ahmetdemirdas/EE493-Revolusys/Documents/About Programming/Image Acquisition Subsytem/test.jpg

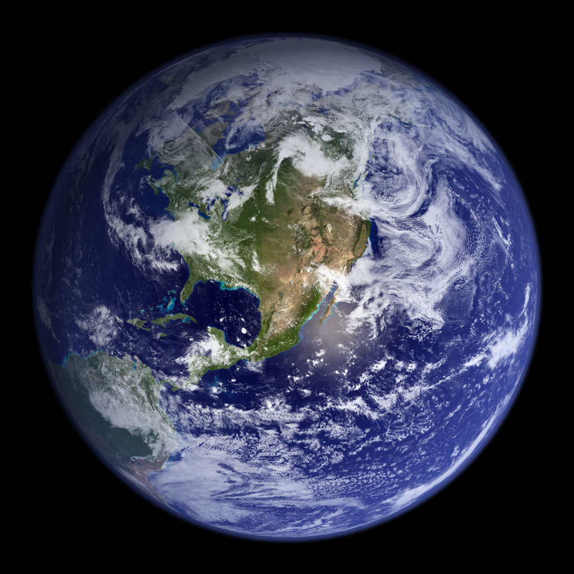
Documents/About Programming/Image Acquisition Subsytem/test.jpg
