ahmetdemirdas/EE493-Revolusys/Documents/About Simulation/layout.jpg

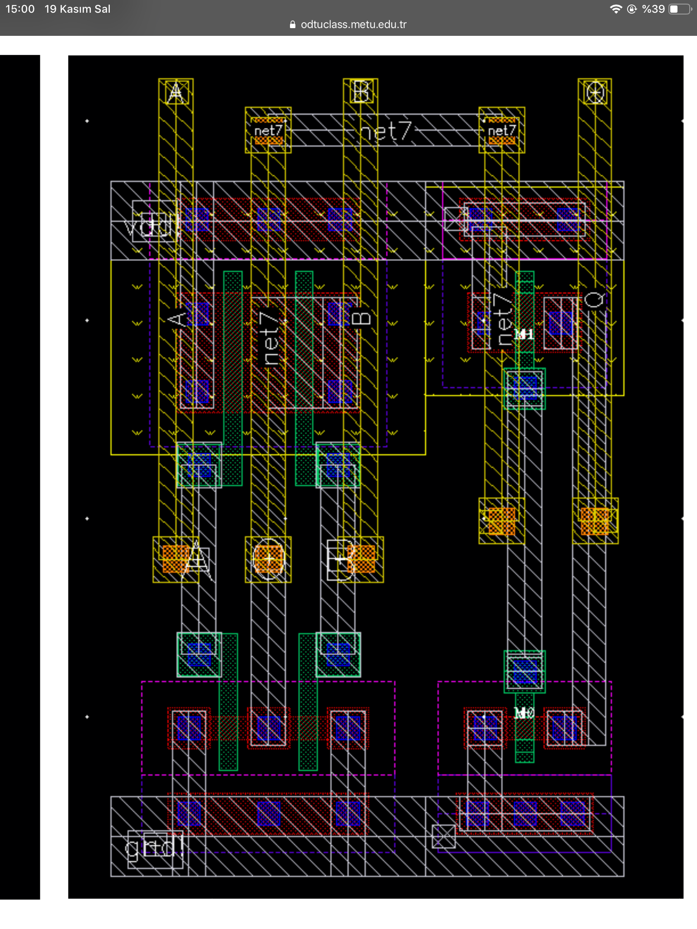
Documents/About Simulation/layout.jpg
