ahmetdemirdas/EE493-Revolusys/README.md

# EE493-Revolusys
This repository serves to EE493/Revolusys Group
