ahmetdemirdas/EE493-Revolusys/Reports/ee493-revolusys-module_demo-corrected.pdf

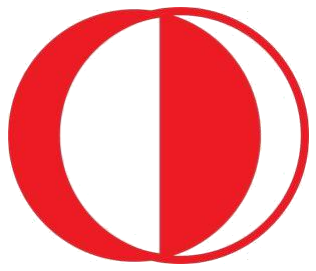
[picture p88: figure]

## MIDDLE EAST TECHNICAL UNIVERSITY

_______________________________________________________

### DEPARTMENT OF ELECTRICAL AND ELECTRONICS

### ENGINEERING

_______________________________________________________

EE 493-DESIGN STUDIO 1

MODULE DEMO

14.12.2019

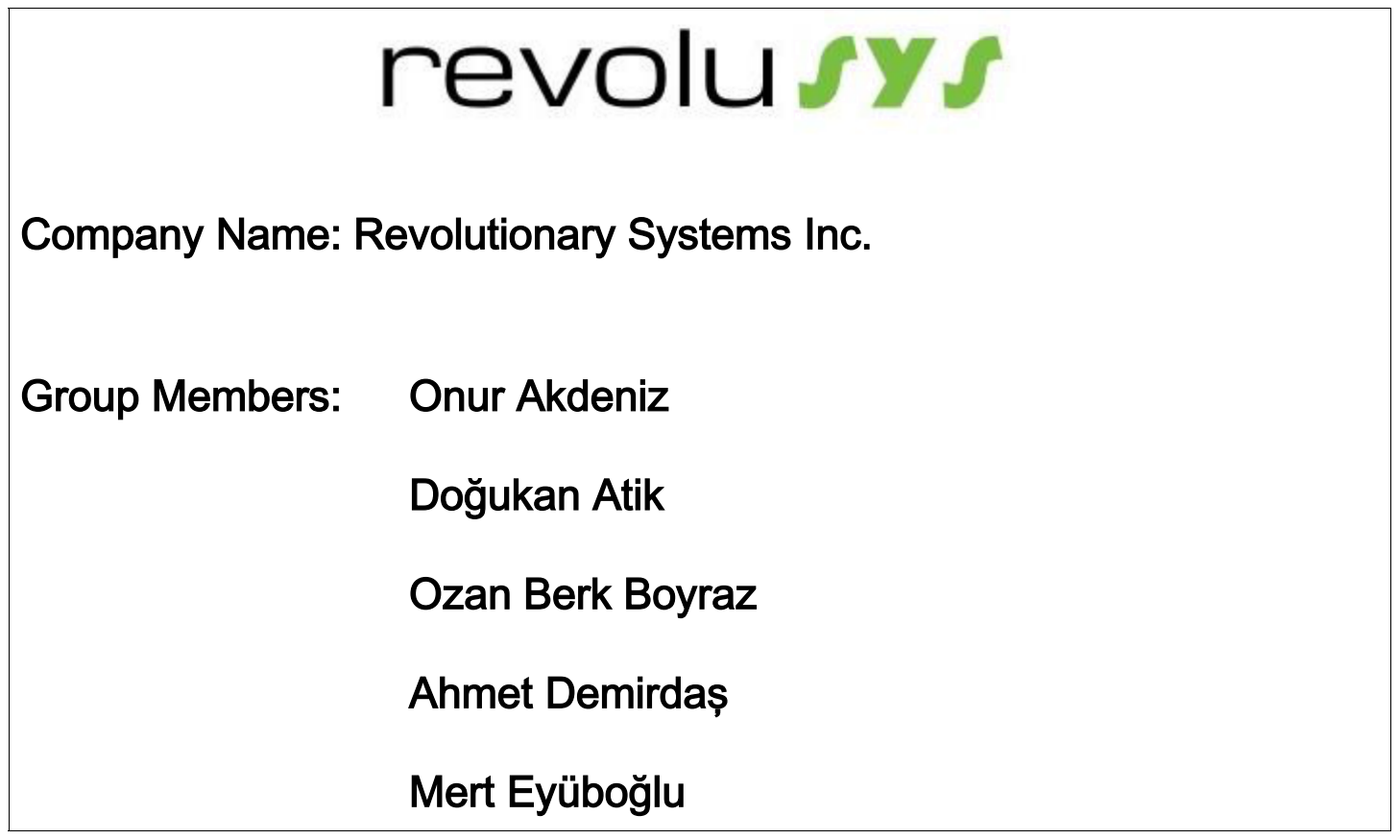
[picture p89: figure]
Group Members:; Onur Akdeniz; Doğukan Atik; Ozan Berk Boyraz; Ahmet Demirdaş; Mert Eyüboğlu

Company Name: Revolutionary Systems Inc.

### 1. Introduction

In Module Demo, Revolusys demonstrated the communication system that utilizes the on-off modulation at 10 kBit/sec data speed. The prepared test plan is described in the following section.

### 2. The Test Plan

The test data stream was upload to input as input and output of the system for transmitter led to receiver photodiode distances from 5 cm to 10 cm (with 1 cm steps) and for different light conditions (dark, lab light , intense light) was observed. This process was repeated 50 times for lab light while it was not performed more than 5 times for other light conditions.

In this demonstration, to illustrate the proper operation of the commination system, 150 bit message signal was transmitted. The number of message bit was selected arbitrarily, the communication system will transmit more than 150 bit at once on its operation. The transmitted stream starts with 6 bit preamble array, “1-1-1-1-1-0”. After this 6 bit of array, “1” bit is sent. After receiving last bit of preamble, “0”, receiver searches for a rising edge. With the rising edge, transmitter arranges its sampling point to mid-point of the high or low durations, to decrease the error. After this 7 bit of information, 150 bit message signal is sent. After 150 bit of message signal, transmitter stops transmitting.

The received data (with digital read command of Arduino), was read on the COM screen of Arduino and compared with the message signal in MATLAB. The number of error in the received 150 bit message signal was determined for different trials and the result seen in Figure 1 was obtained.

The test setups for different conditions are seen from Figure 1 to Figure 3.

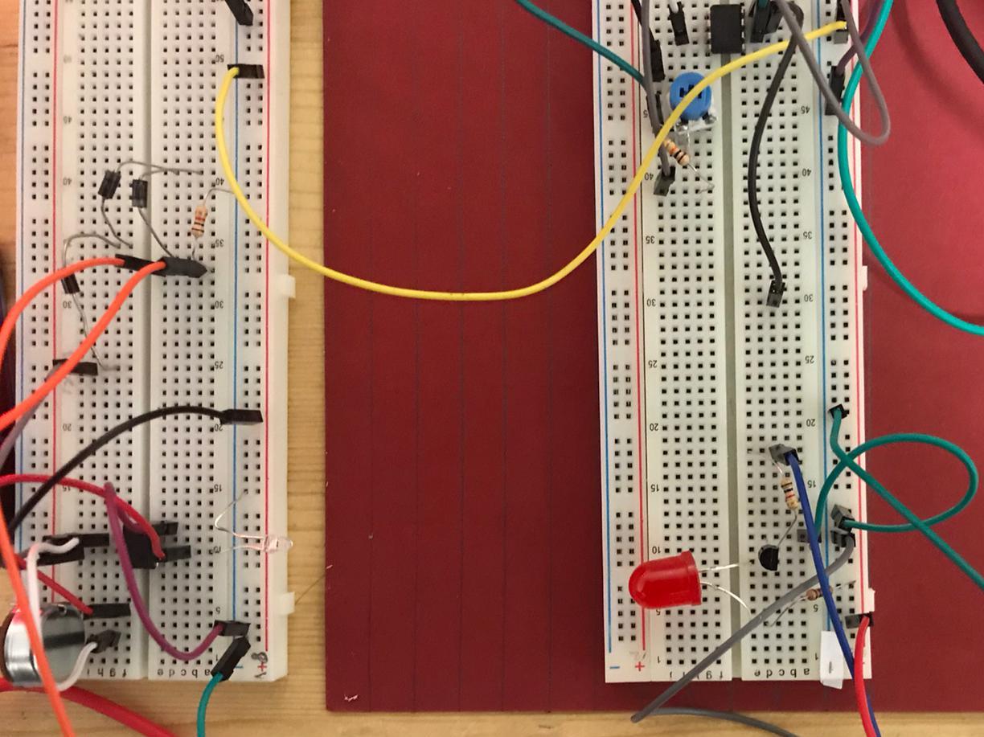
[picture p90: figure]

Figure 1: The setup for lab light condition tests.

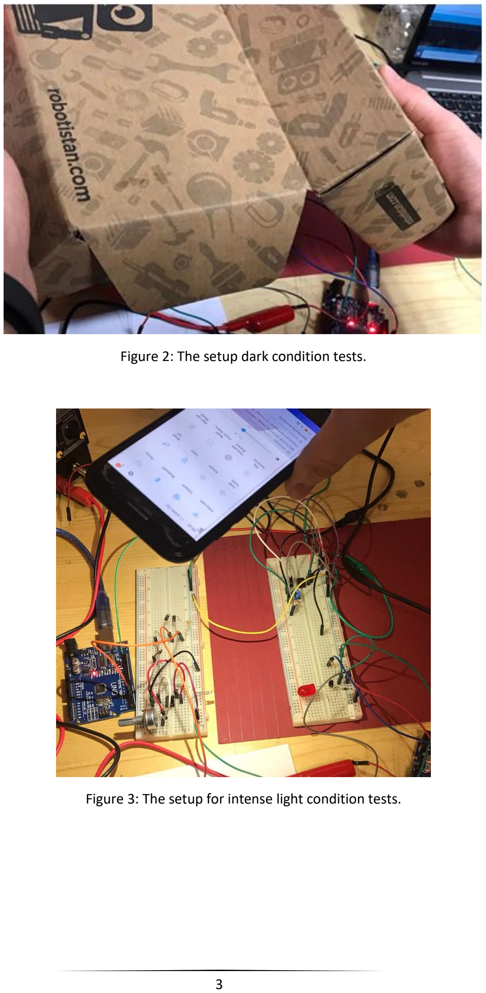
[picture p91: page 3]

Figure 2: The setup dark condition tests.

Figure 3: The setup for intense light condition tests.

### 3. Results

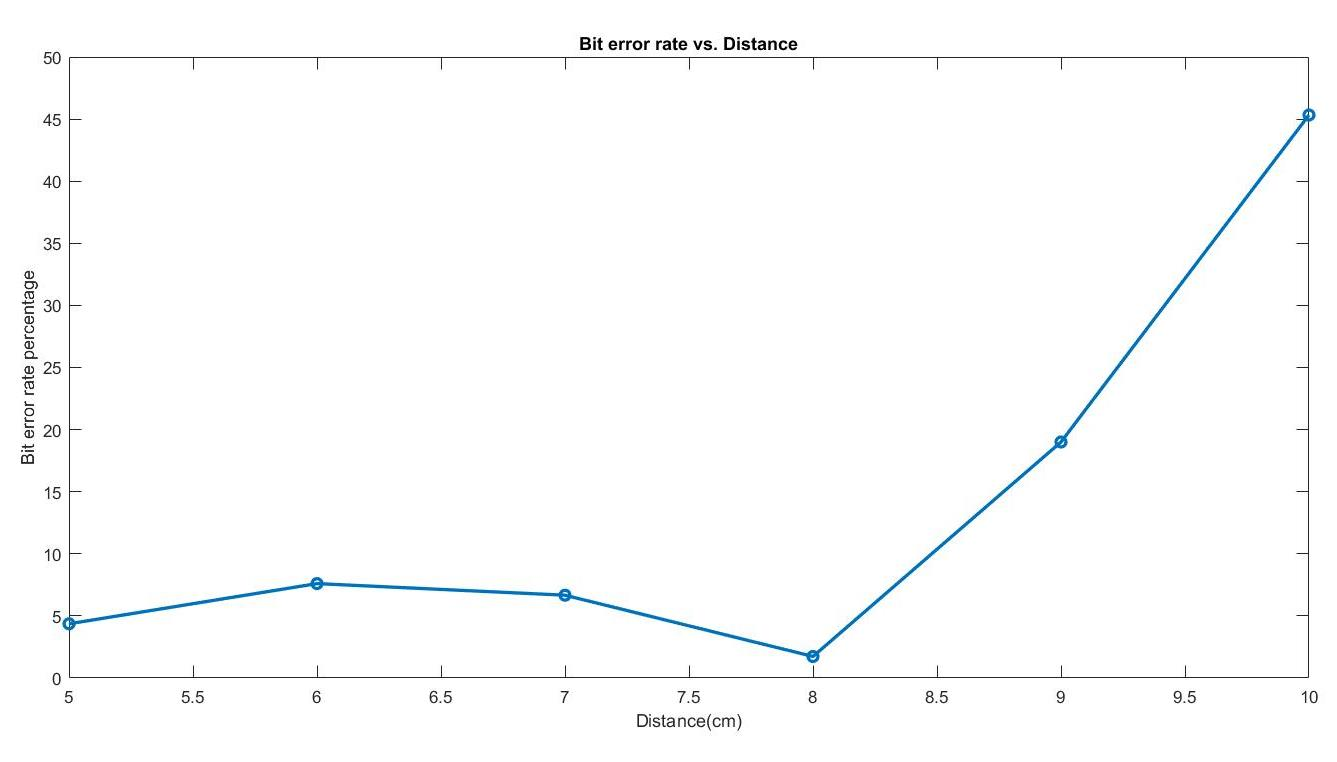
[picture p92: figure]

Figure 4: The obtained bit error rate for varying distance between receiver and transmitter under lab light condition.

As seen in Figure 4, minimum bit-error rate was achieved at 8 cm with less than 5% percent. After 8 cm distance, bit-error rate increases, and communication degrades at 10 cm distance with 45% bit-error rate.
