ahmetdemirdas/EE493-Revolusys/Reports/Revolusys_Weekly_Report_14_November.pdf

## MIDDLE EAST TECHNICAL UNIVERSITY

_______________________________________________________

DEPARTMENT OF ELECTRICAL AND ELECTRONICS ENGINEERING

_______________________________________________________

EE 493-DESIGN STUDIO 1

WEEKLY REPORT VI

Company Name: Revolutionary Systems Inc.

Date: 08.11.2019-13.11.2019

Group Members: | Onur Akdeniz
| Doğukan Atik
| Ozan Berk Boyraz
| Ahmet Demirdaş
| Mert Eyüboğlu

WEEKLY REPORT VI
13.11.2019

## TABLE OF CONTENTS

1.SUMMARY OF THIS WEEK’S PROGRESS

This week, components listed below are ordered:

- Raspberry Pi 3
- Arduino Bluetooth Robot Car Kit

Research on LED driver circuit and the utilization of lenses was conducted.

### 2. RESEARCH ON LED DRIVER CIRCUIT

In the solution of the problem, Revolusys plans to place a Raspberry Pi 3a at the transmitter and receiver terminals. After a photo (data) is uploaded to system as the input, this data will be processed; it will divide into data packets and a compression algorithm will be applied. The resultant data will be modulated and a signal will be produced as one output of Raspberry Pi 3a. At this stage, a driving circuitry will be placed between this output and the corresponding led. A similar circuitry will be necessary at the transmitter part placed on the moving vehicle.

The I-V characteristic of LED is similar to that of normal diode, except that it has steeper slope of If (forward current) vs Vf (forward voltage)in the high current region. As an example to this characteristic, If vs Vf graph of 334-15/T1C1-4WYA 5 mm Round White LED is given in Figure 1.

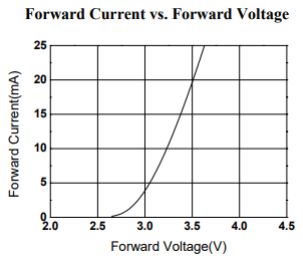
[picture p105: figure]

Figure 1: If vs Vf graph of a LED [1]

Since the light intensity of LED varies with forward current, LED circuitry should be designed to be driven by controlled current source rather than controlled voltage source. With the advancement in semiconductor technology, various suppliers produce constant current LED driver with high output current accuracy.

While designing the driving circuitry for led, it is necessary to provide a current limitation. There are several current limiting methods. These methods along with their advantages and disadvantages are summarized in Table 1.

Table 1: Current limiting methods, their advantages and disadvantages [2]

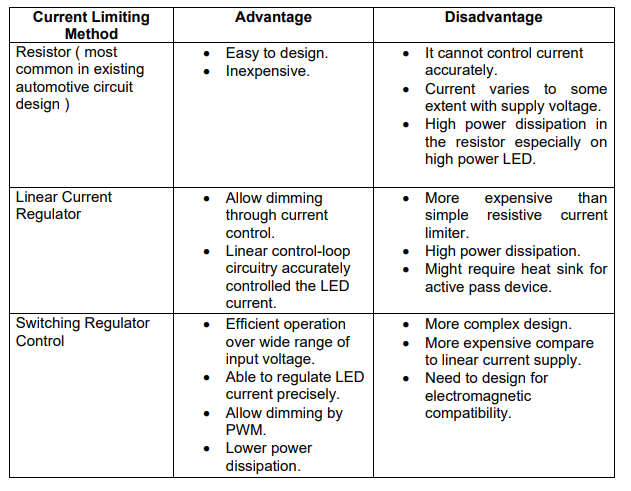
[picture p106: figure]

Examples to usage of resistor and usage of linear current regulator are seen in Figure 2(a) and Figure 2(b). Here, in the circuitry seen in Figure 2(b), linear current regulator NUD4001 produced by On Semiconductor is used.

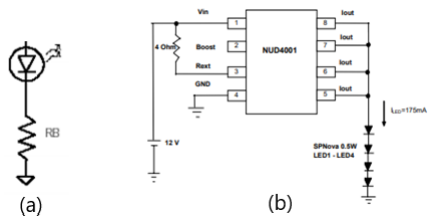
[picture p107: figure]

Figure 2: Examples to a resistor (a) and a linear current regulator (b) as current limiting method [2]

There are different switching LED current control drivers with various functionalities and current matching/regulation. While choosing the switching power supply LED current control driver for a design, supply input voltage level versus the output LED load voltage level should be considered. In general, there are 3 types of topologies for switching power supply: buck regulator, boost regulator and buck/boost regulator.

Buck regulator can function if the input voltage always exceeds the sum of the maximum forward voltages in an array of multiple LEDs. It can reduce the output voltage to a lower level to minimize power loss. [2] In Figure 3, a led driving circuitry utilizing LM3402 (0.5A Constant Current Buck Regulator for High Power LED Drivers, Texas Instruments) is seen.

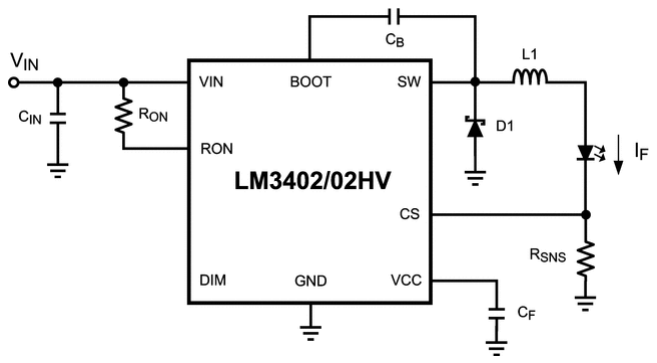
[picture p108: figure]

Figure 3: Example to a buck regulator as current limiting method [3]

When the sum of the entire forward voltages drop in an array of LEDs always exceeds the maximum input voltage, a boost regulator is needed to amplify the output voltage to the required range to drive the LED network. [2] In Figure 4, a led driving circuitry utilizing LT3466 (Dual Full Function White LED Step-Up Converter with Built-In Schottky Diodes, Linear Technology) is seen.

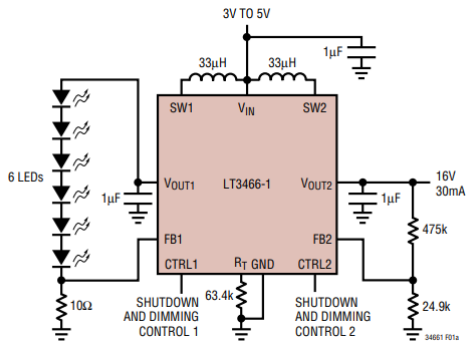
[picture p109: figure]

Figure 4: Example to a boost regulator as current limiting method [4]

When the input voltage may swing above or below the sum of all the forward voltage drop in an array of LEDs, then a buck/boost regulator should be use to drive the LED network. [2] In Figure 5, a led driving circuitry utilizing LT3466 (High Efficiency Torch/Flash LED driver, Linear Technology) is seen.

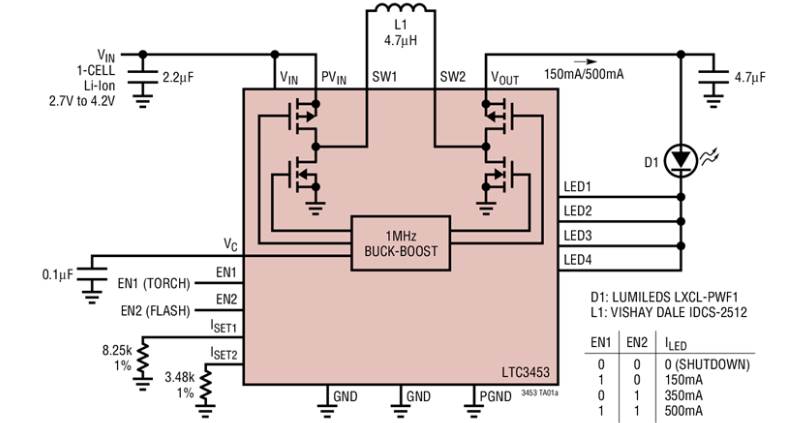
[picture p110: figure]

Figure 5: Example to a buck/boost regulator as current limiting method [5]

For the visible light communication applications, switching type LED driver is a general structure. It has high efficiency and potential in lighting market. The conventional structure to regulate the current of LED is floating buck converter with peak current mode control, which seen in Figure 6. This structure also has pulse width modulation (PWM) circuit to process illumination dimming. [6]

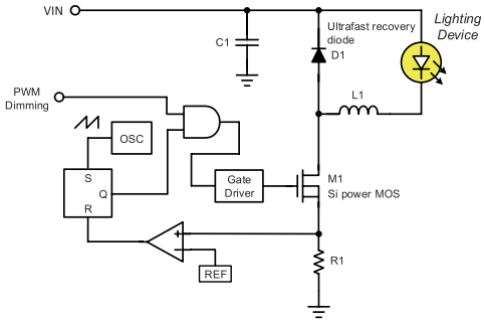
[picture p111: figure]

Figure 6: The conventional structure to regulate the current of LED in VLC systems [6]

Although there are mentioned advantages of switching type LED driver, it has a limitation for the transmission speed at the VLC application. This limitation is due to limited switching speed of traditional silicon power device and its significant switching loss. In practice, frequency is usually lower then several hundreds of kHz. In addition to this, there will be current and voltage ripples at the low switching frequencies thus an energy storing passive element is required to be utilized. A large passive device brings about the lower resonance frequency. Furthermore, the loop bandwidth is usually lower than 10% of switching frequency for stability, which limits the maximum data rate of switching type LED driver to several tens of kb/s. [6]

Lee et al. (2016) proposed the LED driving circuitry seen in Figure 7 to solve the problems mentioned above. To solve the problem of low data rate, the GaN power device is utilized to replace the traditional silicon power device. By exploiting the high switching speed and low switching loss features of GaN, the proposed driving circuit with 10MHz switching frequency is achieved, and available bandwidth for data transmission is increased as well. The maximum of data rate is up to 1Mb/s. [6]

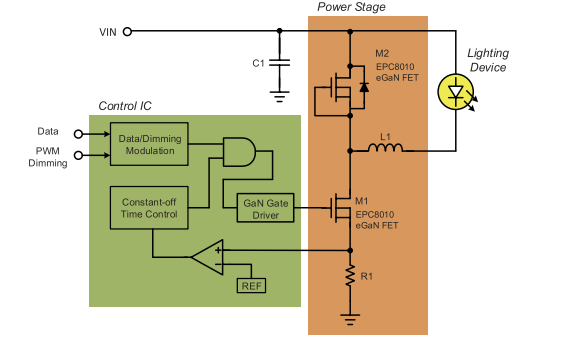
[picture p112: figure]

Figure 7: Proposed solution of Lee et al. for the problem arises at the conventional structure to regulate the current of LED in VLC systems [6]

### 3. UTILIZATION OF LENSES FOR LED TRANSMISSION

At the proposed solution of Revolutionary Systems Inc., it is planned to use 4 LEDs at the transmitter terminal. For very high speed visible light communication, parallel light beams generated via lens between intended transceiver pairs are preferable. To assure the low crosstalk between the transceiver pairs, an optical lens design is required to separate the signals emitted from the transmitting LEDs. [7] The drawback of usage of a lens is decrease at the intensity transmitted to the receiver part. [8]

There are many commercial lens models from different manufacturers. Although, Revolusys can design and produce its own lens, this process would take time and money, which are limited due to nature of the project.

4.CONCLUSION

This week the group members made researches on the electronic part circuitry of the VLC. We are ready to construct the vehicle sub-module since we got the delivery. The next phase of the research is the image compression on Raspberry Pi.

REFERENCES

1. “Technical Data Sheet 5 mm Round ... - futureelectronics.com.” [Online]. Available: http://www1.futureelectronics.com/doc/EVERLIGHT /334-15__T1C1-4WYA.pdf. [Accessed: 13-Nov-2019].
2. “APPLICATION NOTES: LED Electrical Driving Consideration,” Dominant Semi. [Online]. Available: www.dominant-semi.com/cdn/applicationnotes/led_electrical_driving_consideration-verb.pdf. [Accessed: 12-Jul-2011].
3. “LM3402 ACTIVE This product has been released to the market and is available for purchase. For some products, newer alternatives may be available. 0.5A Constant Current Buck Regulator for High Power LED Drivers,” LM3402 0.5A Constant Current Buck
Regulator for High Power LED Drivers | TI.com. [Online]. Available:
http://www.ti.com/product/LM3402#diagrams. [Accessed: 13-Nov-2019].
4. “FEATURES DESCRIPTIO U - analog.com.” [Online]. Available: https://www.analog.com/media/en/technical-documentation/data-sheets/34661f.pdf. [Accessed: 13-Nov-2019].
5. “LTC3453,” LTC3453 Datasheet and Product Info | Analog Devices. [Online]. Available:
https://www.analog.com/en/products/ltc3453.html#product-overview. [Accessed: 13-Nov-2019].
6. Y. C. Lee, “The High-efficiency LED Driver for Visible Light Communication
Applications,” Research Gate, 08-Aug-2016. [Online]. Available: https://www.researchgate.net/publication/306009195_The_High-efficiency_LED_Driver_for_Visible_Light_Communication_Applications/fulltext/581be41708aea429b28feb23/3060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 ail. [Accessed: 13-Nov-2019].
7. S.-B. Li, C. Gong, P. Wang, and Z. Xu, “Lens design for indoor MIMO visible light communications,” Optics Communications, 27-Dec-2016. [Online]. Available: https://www.sciencedirect.com/science/article/pii/S0030401816311130?via=ihub. [Accessed: 13-Nov-2019].
8. “What is the best way to collimate light emitted by a LED?,” Physics Stack Exchange, 2018. [Online]. Available: https://physics.stackexchange.com/questions/100682/what-is-the-best-way-tocollimate-light-emitted-by-a-led. [Accessed: 13-Nov-2019].
