ahmetdemirdas/EE493-Revolusys/Documents/Circuitry/revolusys-communication.asc

D1: LED
D2: diode
D3: diode
D4: diode
D5: zener; BZX84B9V1L
D6: zener; 1N750
F1: f; V3 1
Q1: npn; BC547B
R1: res; 100
R2: res; 20k
R3: res; 1k
U3: LMX58_LM2904
V1: voltage; 9
V2: voltage; PULSE(0 5 0 1f 1f 12.5u 25u 10000)
V3: voltage; 0
V4: voltage; -9
Named nets: 0, 9V, -9V, Vin, Vout
.tran 0 0.01 0
