ahmetdemirdas/EE493-Revolusys/(commit log)

2019-11-13 Create Circuitry
2019-11-13 Lens design for visible light communications
2019-11-13 Catadioptric lenses in VLC
2019-11-13 Create LED-Based Visible Light Communications
2019-11-19 Useful transceiver circuitry
2019-12-05 Create arduino_code
2019-12-17 The communication module circuitry for OOK
2019-12-18 InterruptTheAhmet
    Receiver most up to date version
2020-02-11 Arduino Code for Ultrasound Sensor
2020-03-02 Progress in UART circuitry
